g4bao/70cm_driver/BATC_test/05 Amp at 550ma 27dBm.JPG

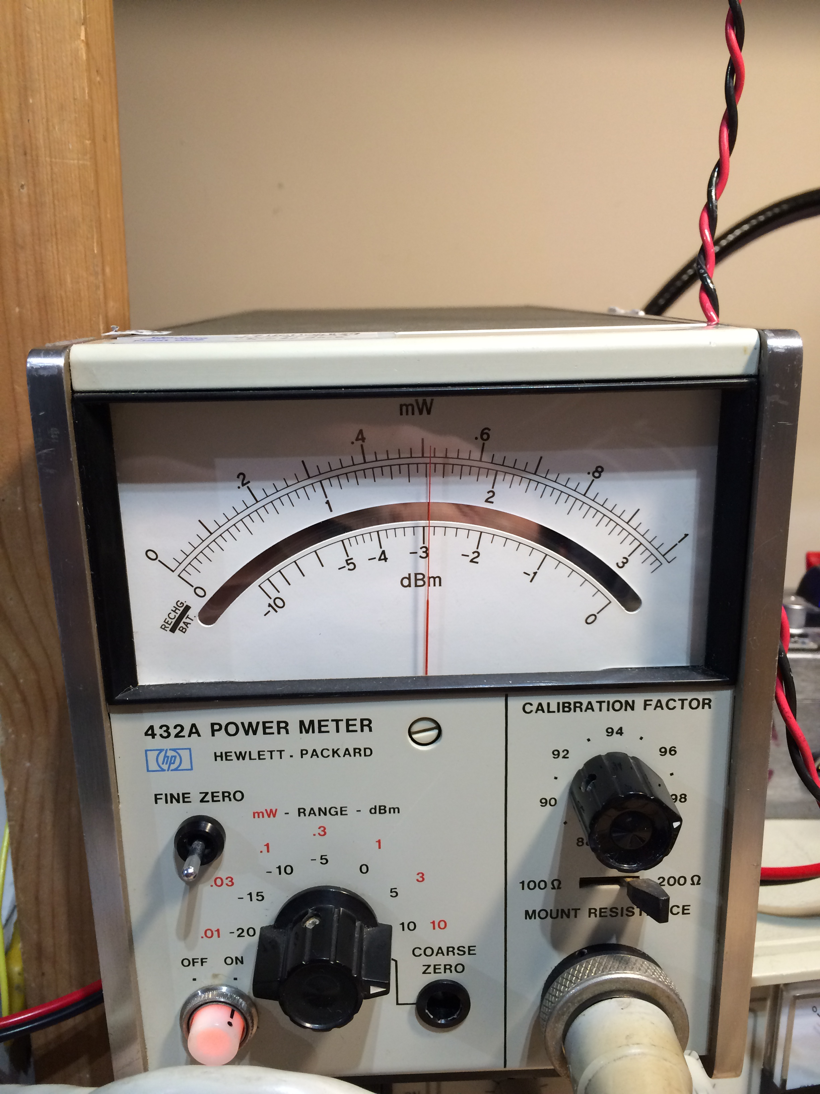
BATC_test/05 Amp at 550ma 27dBm.JPG
