g4bao/70cm_driver/BATC_test/02 Photo1.JPG

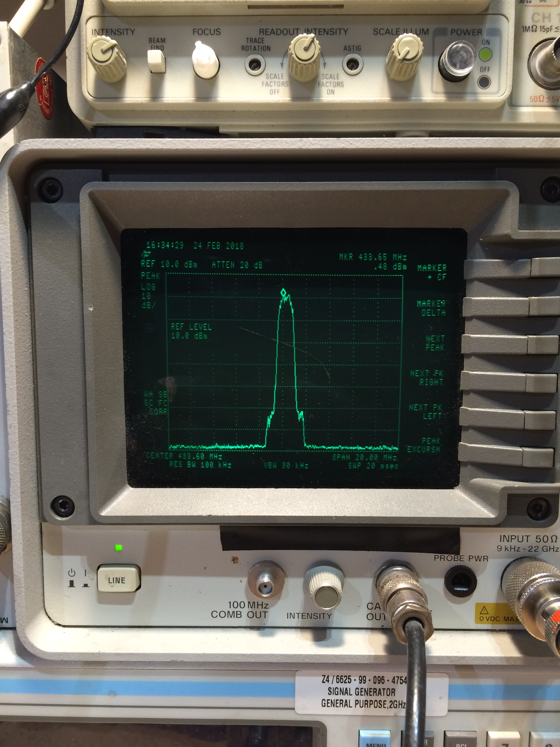
BATC_test/02 Photo1.JPG
