g4bao/70cm_driver/BATC_test/01 Setup.JPG

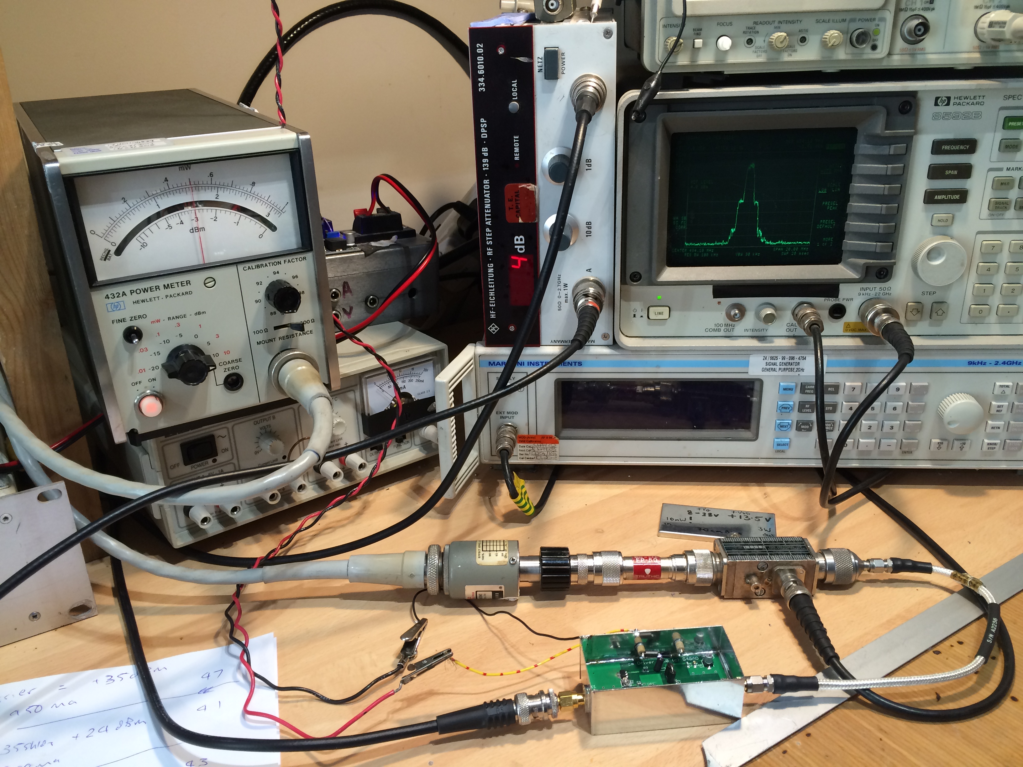
BATC_test/01 Setup.JPG
