g4bao/70cm_driver/BATC_test/03 Xpress source +4dBm.JPG

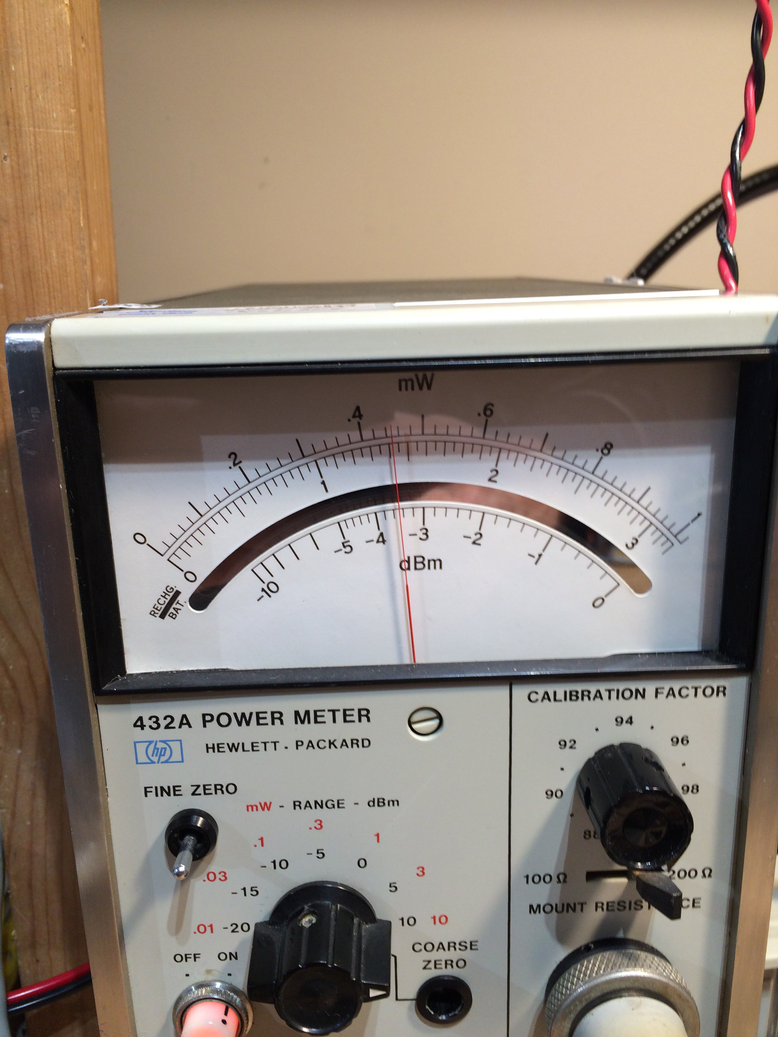
BATC_test/03 Xpress source +4dBm.JPG
