g4bao/70cm_driver/BATC_test/04 Amp at 550ma.JPG

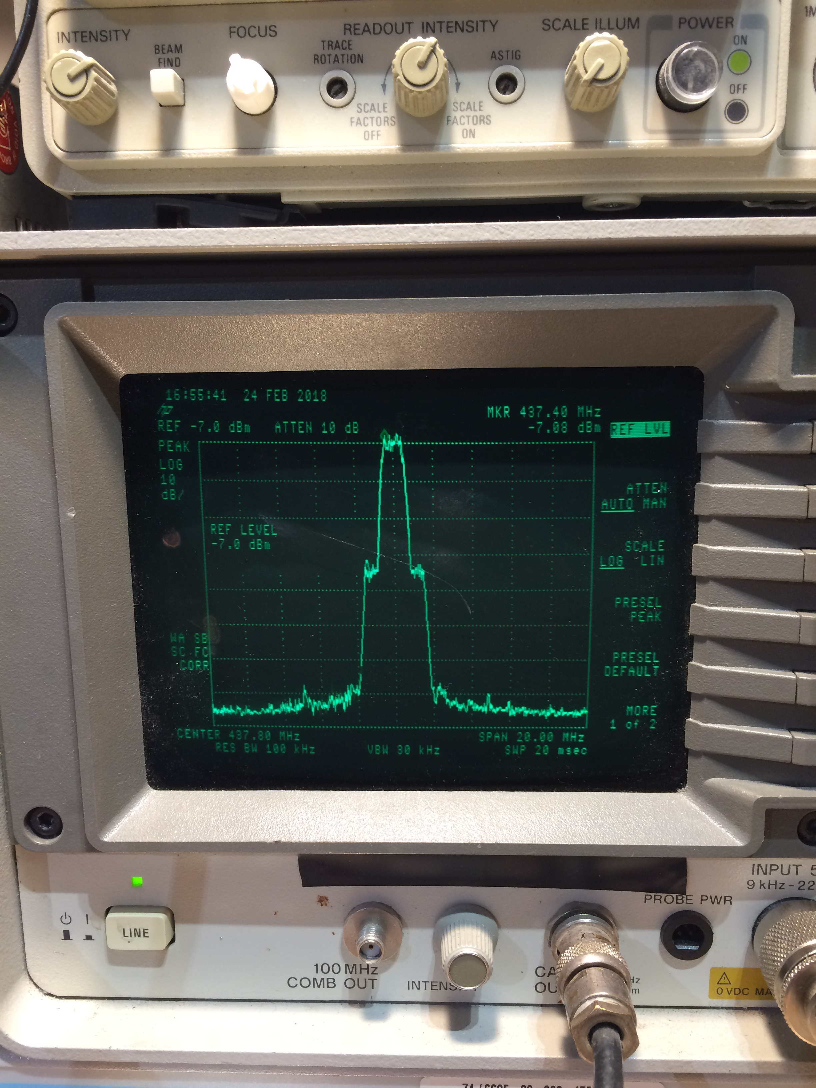
BATC_test/04 Amp at 550ma.JPG
