g4bao/70cm_driver/BATC_test/06 Amp at 350ma.JPG

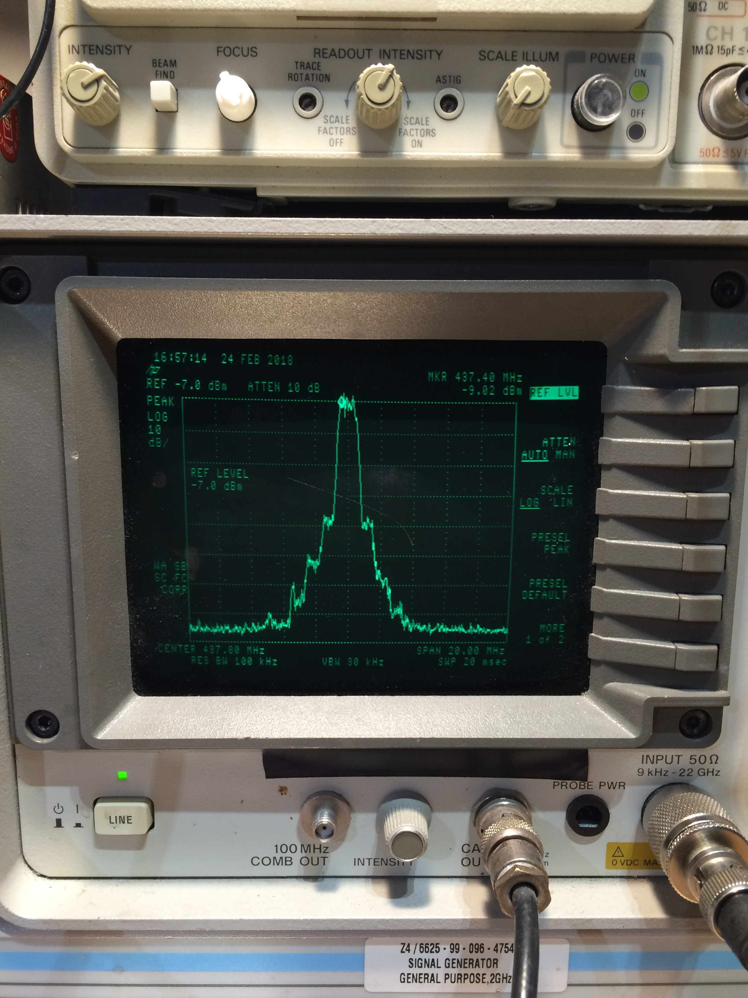
BATC_test/06 Amp at 350ma.JPG
