g4bao/70cm_driver/BATC_test/07 Amp at 350ma 26dBm.JPG

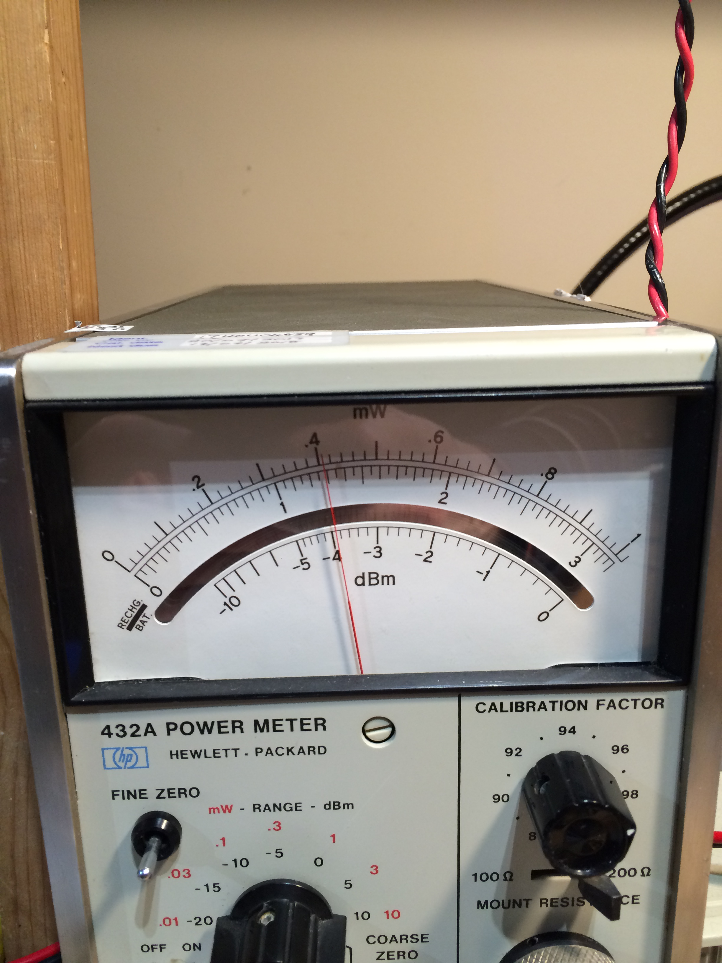
BATC_test/07 Amp at 350ma 26dBm.JPG
