g4bao/70cm_driver/BATC_test/08 Pdown source.JPG

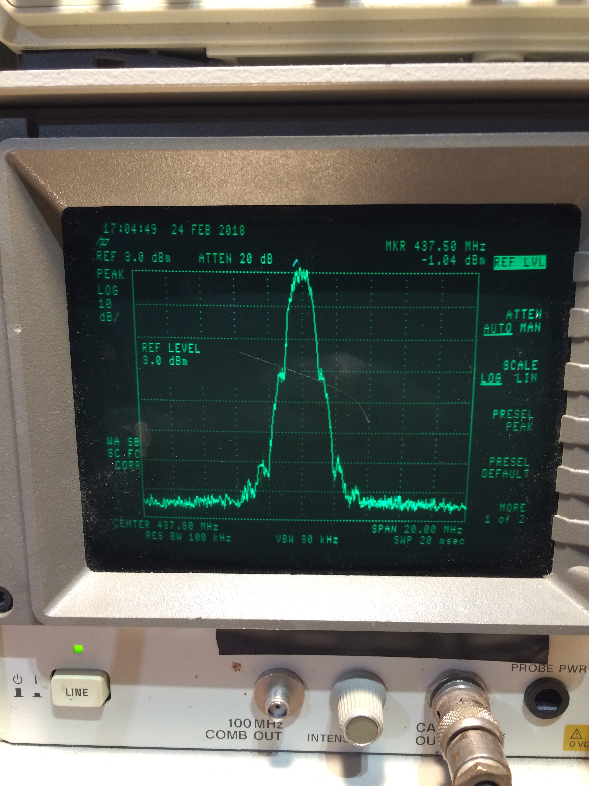
BATC_test/08 Pdown source.JPG
