g4bao/70cm_driver/BATC_test/09 Pdown source level.JPG

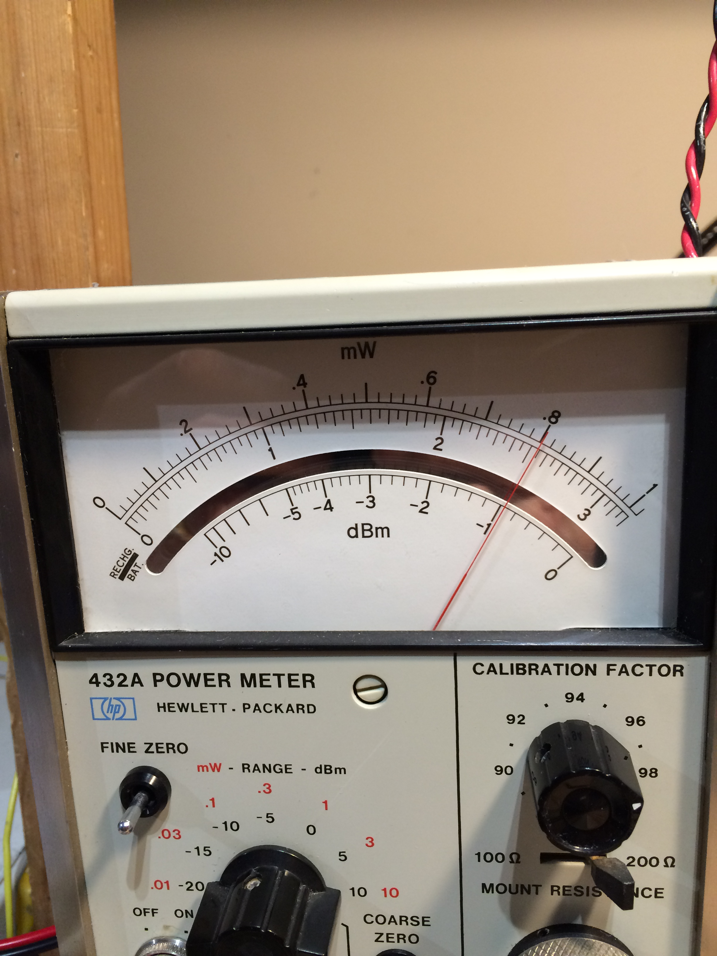
BATC_test/09 Pdown source level.JPG
