g4bao/70cm_driver/BATC_test/10 Pdown at 650ma.JPG

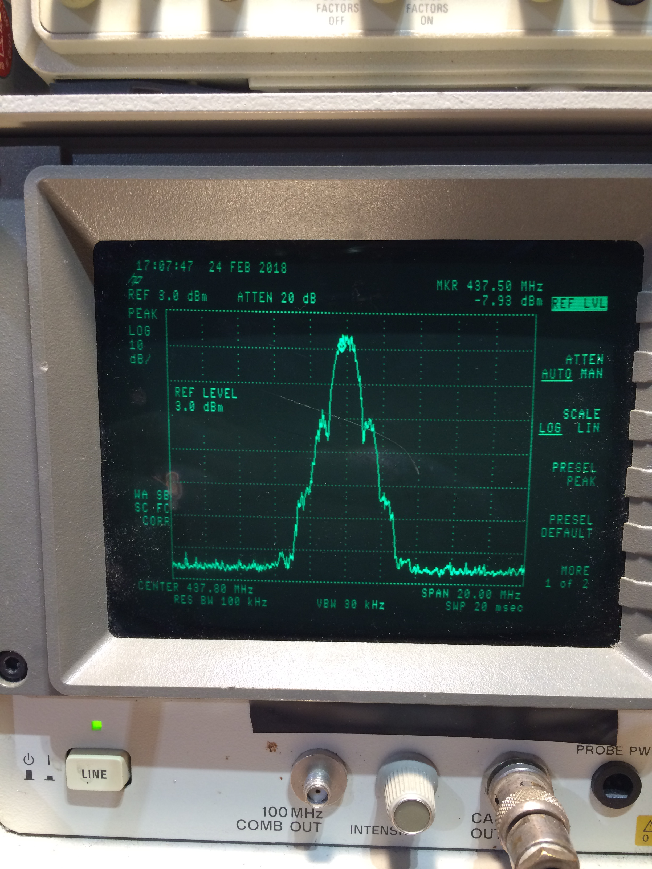
BATC_test/10 Pdown at 650ma.JPG
