g4bao/70cm_driver/BATC_test/11 Pdown at 650ma 29dBm.JPG

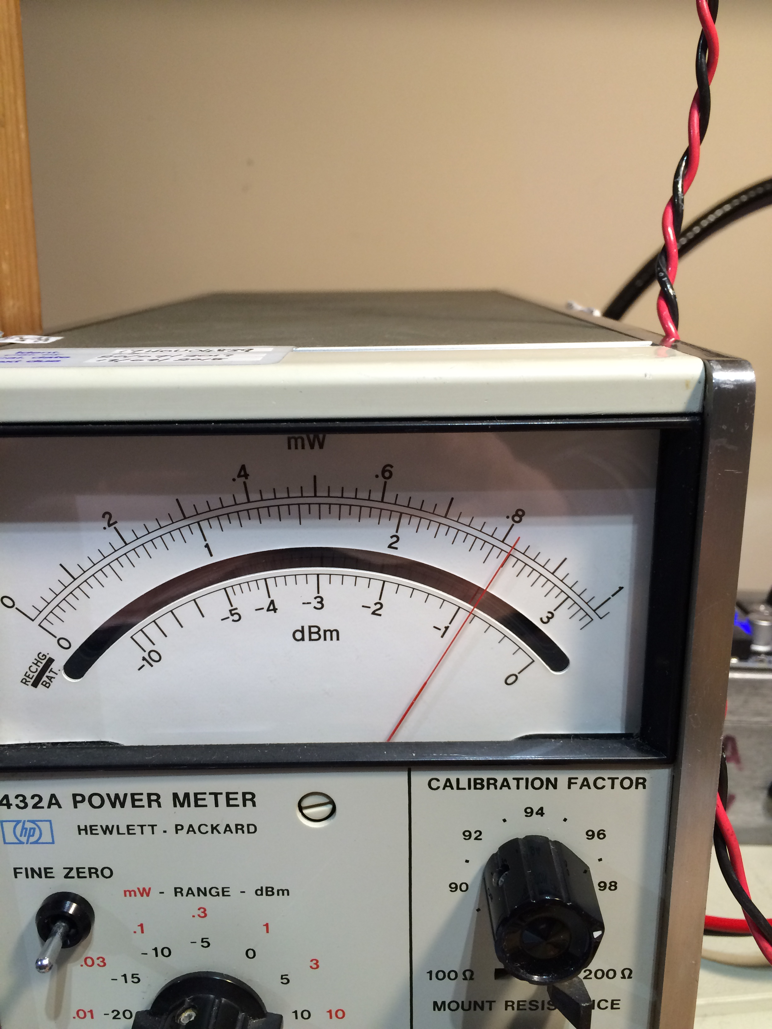
BATC_test/11 Pdown at 650ma 29dBm.JPG
