g4bao/70cm_driver/BATC_test/12 Pdown 3db 550ma.JPG

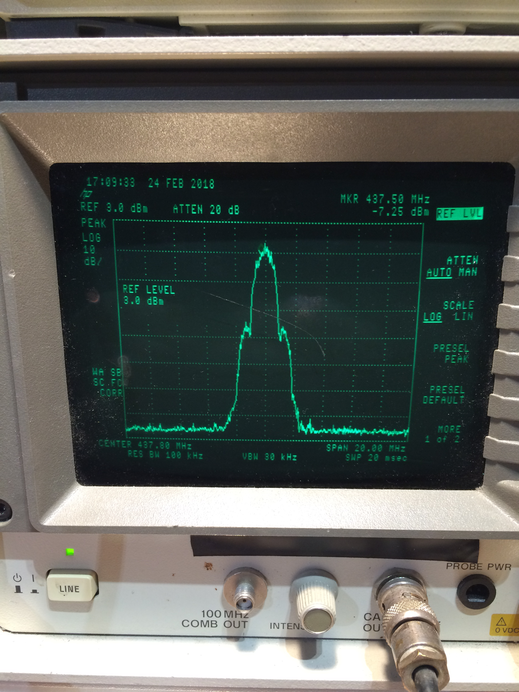
BATC_test/12 Pdown 3db 550ma.JPG
