g4bao/70cm_driver/BATC_test/13 Pdown 3dB 550ma 27dBm.JPG

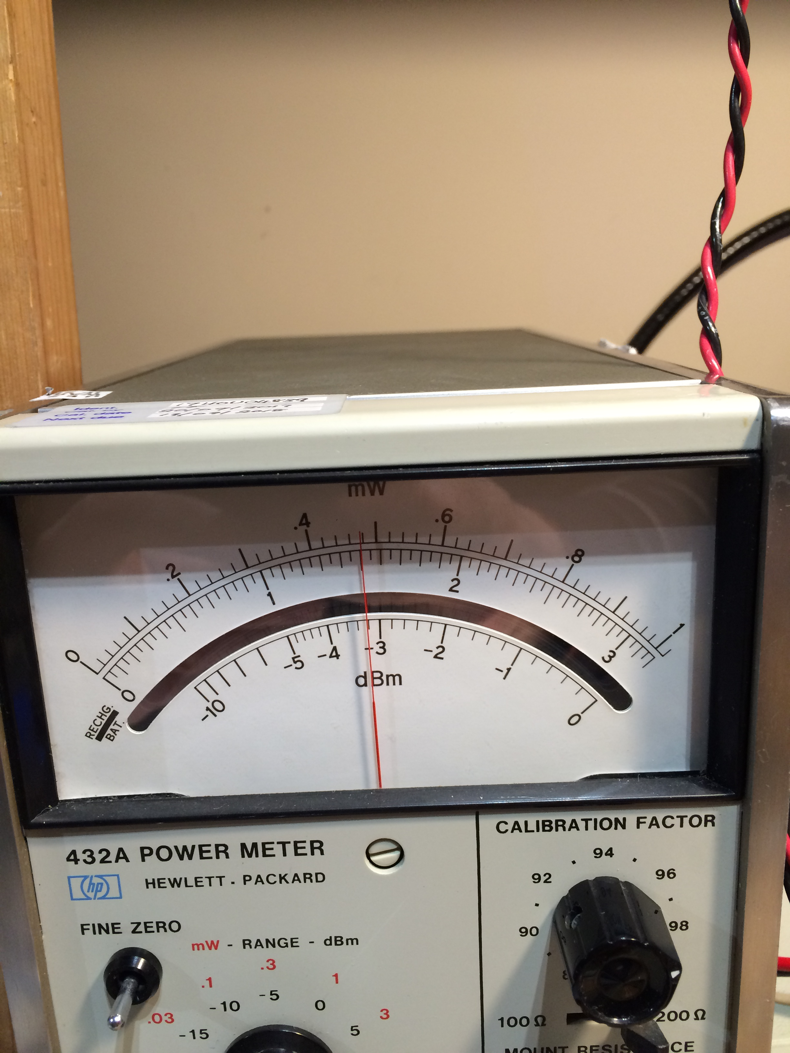
BATC_test/13 Pdown 3dB 550ma 27dBm.JPG
