g4bao/70cm_driver/BATC_test/14 Pdown 3dB 350ma.JPG

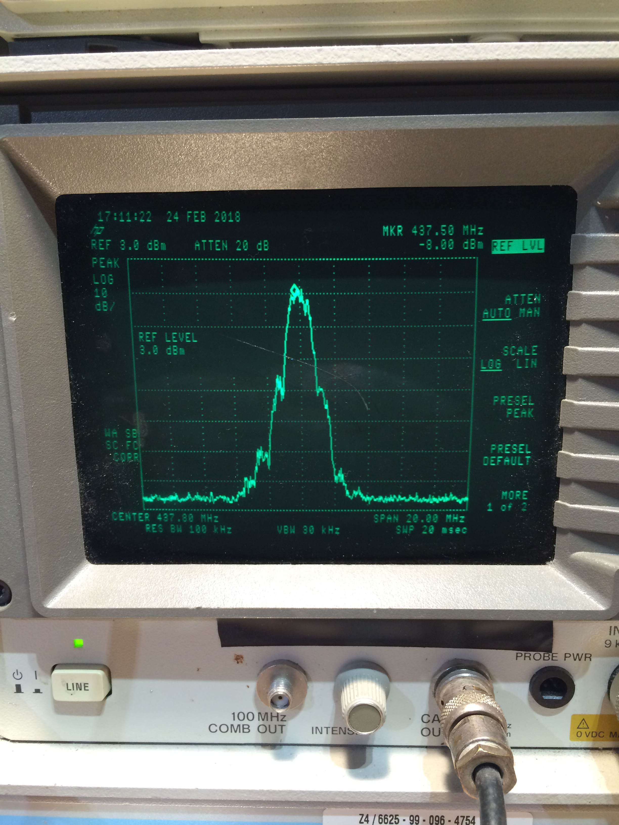
BATC_test/14 Pdown 3dB 350ma.JPG
