g4bao/70cm_driver/BATC_test/15 Pdown 3dB 350ma 26dBm.JPG

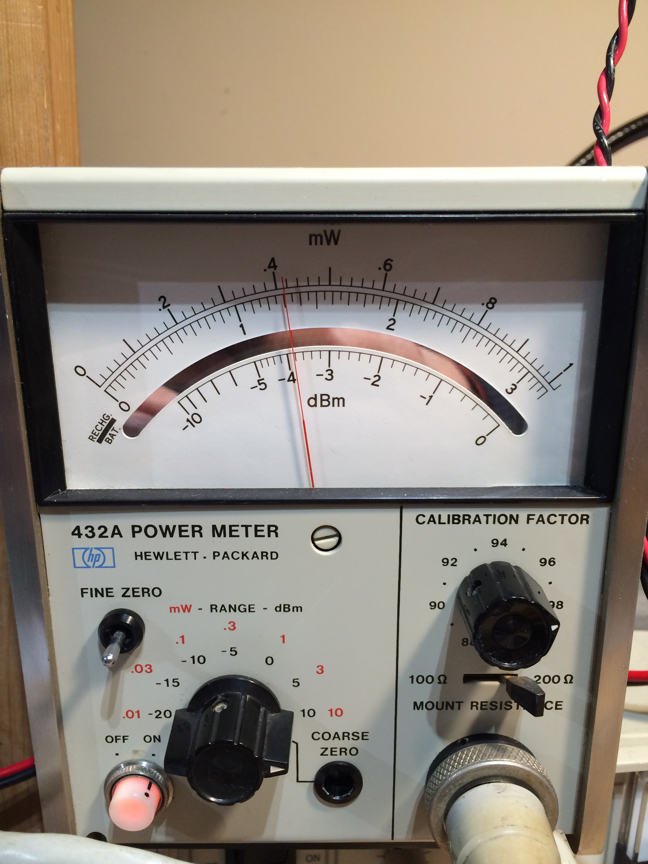
BATC_test/15 Pdown 3dB 350ma 26dBm.JPG
