g4bao/70cm_driver/Eagle_files/AFT05MS004N_70.brd

## EAGLE design Eagle_files/AFT05MS004N_70.brd (2026-11-02)

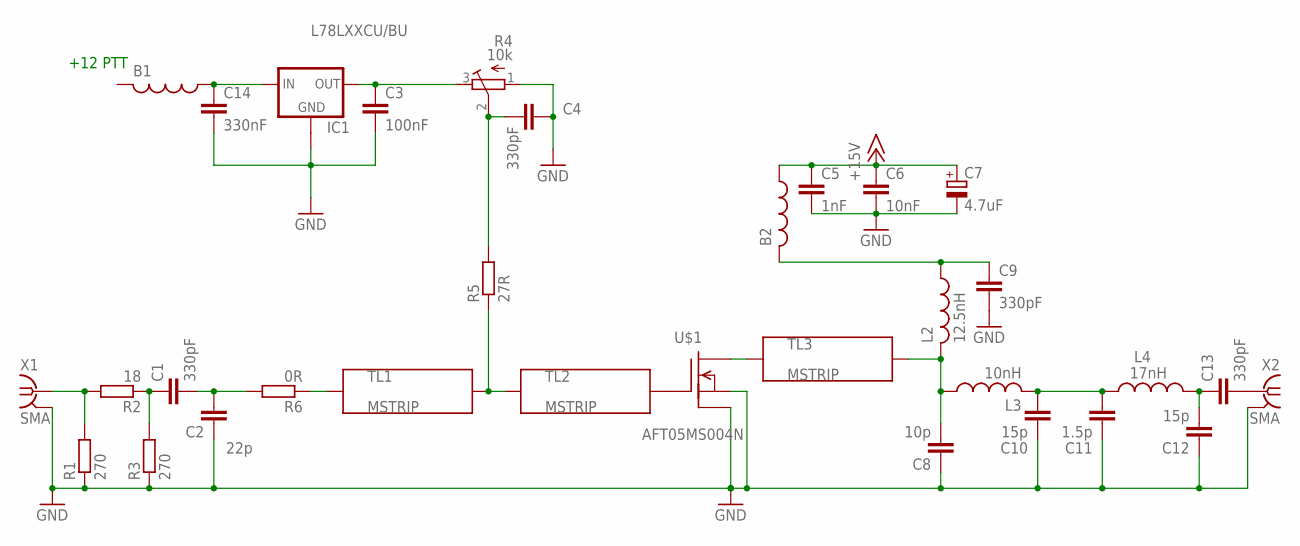
[picture p26: schematic AFT05MS004N_70.sch]

Parts:
B1, B2: L-US0204/5; 0204/5
C1, C13: 330pF; C0805
C2: 22p; C0603
C3: 100nF; C0805
C4, C9: 330pF; C0603
C5: 1nF; C0603
C6: 10nF; C0805
C7: 4.7uF; SANYO-OSCON_SMD_B6
C8: 10p; C0603
C10, C12: 15p; C0603
C11: 1.5p; C0603
C14: 330nF; C0805
IC1: L78LXXCU/BU; SOT89
L2: 12.5nH; 0805
L3: 10nH; 0805
L4: 17nH; 0805
R1, R3: 270; R0603
R2: 18; R0603
R4: 10k; RTRIM3214W
R5: 27R; R0603
R6: 0R; R0603
TL1, TL2, TL3: MSTRIP; TRLINE2
U$1: AFT05MS004N; SOT-89
X1, X2: SMA; J502-ND-142-0711-871/876

Connections:
+13.6: B2.1, C5.1, C6.1, C7.+
GND: C2.1, C3.2, C4.1, C5.2, C6.2, C7.-, C8.1, C9.2, C10.1, C11.1, C12.1, C14.2, IC1.4 (GND1), R1.1, R3.1, R4.1 (E), U$1.2 (S), U$1.2@1 (S1), X1.G@1 (GND), X1.G@2 (GND), X1.G@3 (GND), X1.G@4 (GND), X2.G@1 (GND), X2.G@2 (GND), X2.G@3 (GND), X2.G@4 (GND)
unnamed: R1.2, R2.2, X1.1
unnamed: B2.2, C9.1, L2.1
unnamed: C13.2, X2.1
unnamed: R6.1, TL1.P$1 (1)
unnamed: C4.2, R4.2 (S), R5.2
unnamed: C8.2, L2.2, L3.1, TL3.P$2 (2)
unnamed: B1.1, C14.1, IC1.3 (IN)
unnamed: C1.2, C2.2, R6.2
unnamed: C3.1, IC1.1 (OUT), R4.3 (A)
unnamed: C10.2, C11.2, L3.2, L4.1
unnamed: C12.2, C13.1, L4.2
unnamed: C1.1, R2.1, R3.2
unnamed: TL2.P$2 (2), U$1.1 (G)
unnamed: R5.1, TL1.P$2 (2), TL2.P$1 (1)
unnamed: TL3.P$1 (1), U$1.3 (D)

Notes on the sheet:
+12 PTT

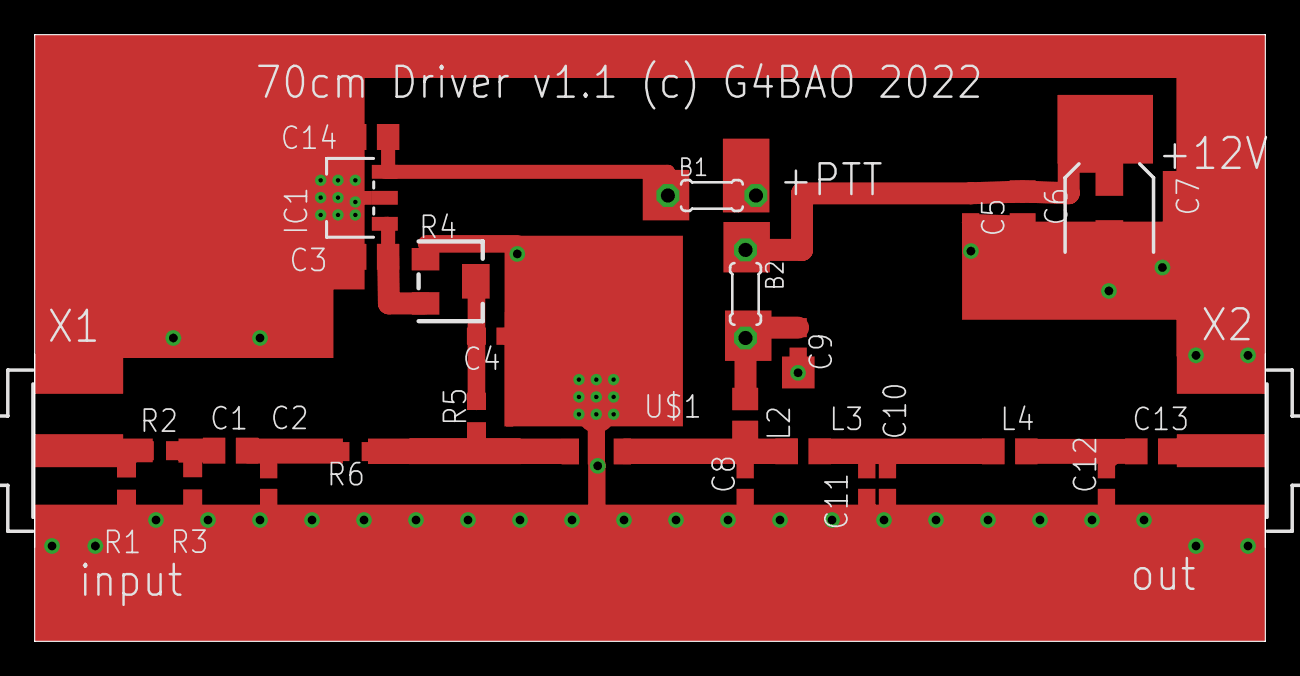
[picture p27: board AFT05MS004N_70.brd from above]

Board: 2 copper layers, 71.0 x 35.0 mm, 32 parts (0 on the bottom side), 17 nets.
