g4bao/70cm_driver/(commit log)

2026-11-02 Create BATC_tests
    Results measured on the board by BATC
2026-11-02 Update README with additional project details
    Added details about included schematics, PCB layout, and Gerber files.
